henry781/binary-clock/hardware/bom.csv

References | Qty | Value | Description | Footprint | Manufacturer | MPN | Notes
U_MCU1 | 1 | ATmega328P-PU | 8-bit AVR microcontroller | Package_DIP:DIP-28_W7.62mm | Microchip | ATmega328P-PU | Narrow DIP-28; programmed over ISP
U3, U4, U5 | 3 | CD4040BE | 12-stage binary ripple counter, CMOS | Package_DIP:DIP-16_W7.62mm | Texas Instruments | CD4040BE
U11, U12, U13 | 3 | SN74HC245N | Octal bus transceiver, 3-state outputs | Package_DIP:DIP-20_W7.62mm | Texas Instruments | SN74HC245N | HC family (not HCT or LS)
U_LDO1 | 1 | MCP1700-3302E | 3.3 V LDO regulator, 250 mA | Package_TO_SOT_THT:TO-92_Inline_Wide | Microchip | MCP1700-3302E/TO | Pinout GND-VIN-VOUT; spread the leads to the 2.54 mm pitch
Q_DCF1 | 1 | 2N3904 | NPN transistor, level shifter | Package_TO_SOT_THT:TO-92_Inline_Wide | onsemi | 2N3904BU | Pinout E-B-C; spread the leads to the 2.54 mm pitch
Q_PT1 | 1 | TEPT5700 | Ambient light phototransistor, 5 mm | LED_THT:LED_D5.0mm | Vishay | TEPT5700 | Collector (short lead, flat side) on the square pad, like an LED
MOD_DCF1 | 1 | DCF-3850M-800 | DCF77 receiver module with ferrite antenna, 3.3 V | binary_clock:DCF77_Module_RC8000_Castellated_21.5x13mm |  | DCF-3850M-800 | Sold as "DCF77 receiver module DCF-3850M-800" (e.g. TinyTronics), 3.3 V version; antenna supplied; soldered flat by its castellated pads
Y1 | 1 | 32.768 kHz | Watch crystal, CL 12.5 pF, ±20 ppm | Crystal:Crystal_C38-LF_D3.0mm_L8.0mm_Horizontal | KDS | DT-38 | Load capacitance 12.5 pF (LCSC C93228)
D_R1-D_R5 | 5 | Red | LED 10 mm, red 625 nm, diffused, 60° | LED_THT:LED_D10.0mm | OptoSupply | OS5RPMA162A-LM | Any 10 mm diffused red LED, Vf ≈ 2.0 V
D_G1-D_G6 | 6 | Green | LED 10 mm, green 525 nm, diffused, 60° | LED_THT:LED_D10.0mm | OptoSupply | OSPG0262A-MN | Any 10 mm diffused green LED, Vf ≈ 3.2 V
D_B1-D_B6 | 6 | Blue | LED 10 mm, blue 470 nm, diffused, 60° | LED_THT:LED_D10.0mm | OptoSupply | OSB5SAA162A-KL | Any 10 mm diffused blue LED, Vf ≈ 3.2 V
D_TERM1 | 1 | 1N5817 | Schottky diode, 20 V 1 A | Diode_THT:D_DO-41_SOD81_P10.16mm_Horizontal | Vishay | 1N5817-E3/54 | Reverse-polarity protection
C_DEC_U3, C_DEC_U4, C_DEC_U5, C_DEC_U11, C_DEC_U12, C_DEC_U13, C_DEC_MCU_VCC1, C_DEC_MCU_AVCC1, C_AREF1, C_DCF_VCC1, C_PT1 | 11 | 100nF | Ceramic capacitor, X7R, 50 V, radial | Capacitor_THT:C_Disc_D5.0mm_W2.5mm_P5.00mm | KEMET | C322C104K5R5TA | Or any X7R radial MLCC with 5 mm lead spacing
C_LDO_IN1, C_LDO_OUT1 | 2 | 1uF | Ceramic capacitor, X7R, 50 V, radial | Capacitor_THT:C_Disc_D5.0mm_W2.5mm_P5.00mm | KEMET | C322C105K5R5TA | Must be ceramic (MCP1700 stability); this body is 7.4 mm wide, mount it slightly tilted or use a narrower 1 uF X7R part with 5 mm lead spacing
C1, C2 | 2 | 15pF | Ceramic capacitor, C0G/NP0, radial | Capacitor_THT:C_Disc_D5.0mm_W2.5mm_P5.00mm | SR Passives | CC-15/100 | C0G required (crystal load); 10 pF or 22 pF to trim the crystal frequency
C_BULK1 | 1 | 100uF | Aluminum electrolytic capacitor, 16 V, 105 °C | Capacitor_THT:CP_Radial_D6.3mm_P2.50mm | Panasonic | EEU-FC1C101 | Ø6.3 mm, 2.5 mm lead spacing
L_AVCC1 | 1 | 600R @ 100MHz | Ferrite bead, axial | Inductor_THT:L_Axial_L9.5mm_D4.0mm_P12.70mm_Horizontal_Fastron_SMCC | Würth Elektronik | 7427503 | Any axial bead of 600 Ω or more at 100 MHz; a body under Ø4.5 mm clears the MCU socket more easily
R_LED_R1-R_LED_R5 | 5 | 330 | Resistor, metal film, 0.25 W, 1 % | Resistor_THT:R_Axial_DIN0207_L6.3mm_D2.5mm_P10.16mm_Horizontal | Yageo | MFR-25FBF52-330R
R_LED_G1-R_LED_G6, R_LED_B1-R_LED_B6 | 12 | 220 | Resistor, metal film, 0.25 W, 1 % | Resistor_THT:R_Axial_DIN0207_L6.3mm_D2.5mm_P10.16mm_Horizontal | Yageo | MFR-25FBF52-220R
R_DCF_C1, R_DCF_OUT1, R_OE1, R_RST1 | 4 | 10k | Resistor, metal film, 0.25 W, 1 % | Resistor_THT:R_Axial_DIN0207_L6.3mm_D2.5mm_P10.16mm_Horizontal | Yageo | MFR-25FBF52-10K
R_PT1 | 1 | 470k | Resistor, metal film, 0.25 W, 1 % | Resistor_THT:R_Axial_DIN0207_L6.3mm_D2.5mm_P10.16mm_Horizontal | Yageo | MFR-25FBF52-470K | Sets the light-sensor range
R_DCF_VCC1 | 1 | 100 | Resistor, metal film, 0.25 W, 1 % | Resistor_THT:R_Axial_DIN0207_L6.3mm_D2.5mm_P10.16mm_Horizontal | Yageo | MFR-25FBF52-100R
SW1, SW2, SW3 | 3 | SW_Push | Tactile switch, 6 × 6 mm | Button_Switch_THT:SW_PUSH_6mm | C&K | PTS645SL50-2 LFS | Any 6 × 6 mm through-hole tactile switch
J_PWR2 | 1 | Screw terminal | Terminal block, 2 positions, 5.00 mm pitch | TerminalBlock_Phoenix:TerminalBlock_Phoenix_MKDS-1,5-2_1x02_P5.00mm_Horizontal | Phoenix Contact | 1715022 | MKDS 1,5/ 2 with 5.00 mm pitch; 5.08 mm variants do not fit
J_ISP1 | 1 | ISP Header | Pin header, 2 × 3, 2.54 mm | Connector_PinHeader_2.54mm:PinHeader_2x03_P2.54mm_Vertical | Würth Elektronik | 61300621121
J_DBG1 | 1 | UART Header | Pin header, 1 × 3, 2.54 mm | Connector_PinHeader_2.54mm:PinHeader_1x03_P2.54mm_Vertical | Würth Elektronik | 61300311121 | Optional (debug output)
Socket for U_MCU1 | 1 | DIP-28 | IC socket, machined pins, 7.62 mm row spacing |  | Preci-Dip | 110-93-328-41-001000 | Not in the schematic; narrow (7.62 mm) socket
Sockets for U3, U4, U5 | 3 | DIP-16 | IC socket, machined pins, 7.62 mm row spacing |  | Preci-Dip | 110-93-316-41-001000 | Not in the schematic
Sockets for U11, U12, U13 | 3 | DIP-20 | IC socket, machined pins, 7.62 mm row spacing |  | Preci-Dip | 110-93-320-41-001000 | Not in the schematic
