henry781/binary-clock/hardware/binary_clock.kicad_pcb

## KiCad design hardware/binary_clock.kicad_pcb (2026-10-31)

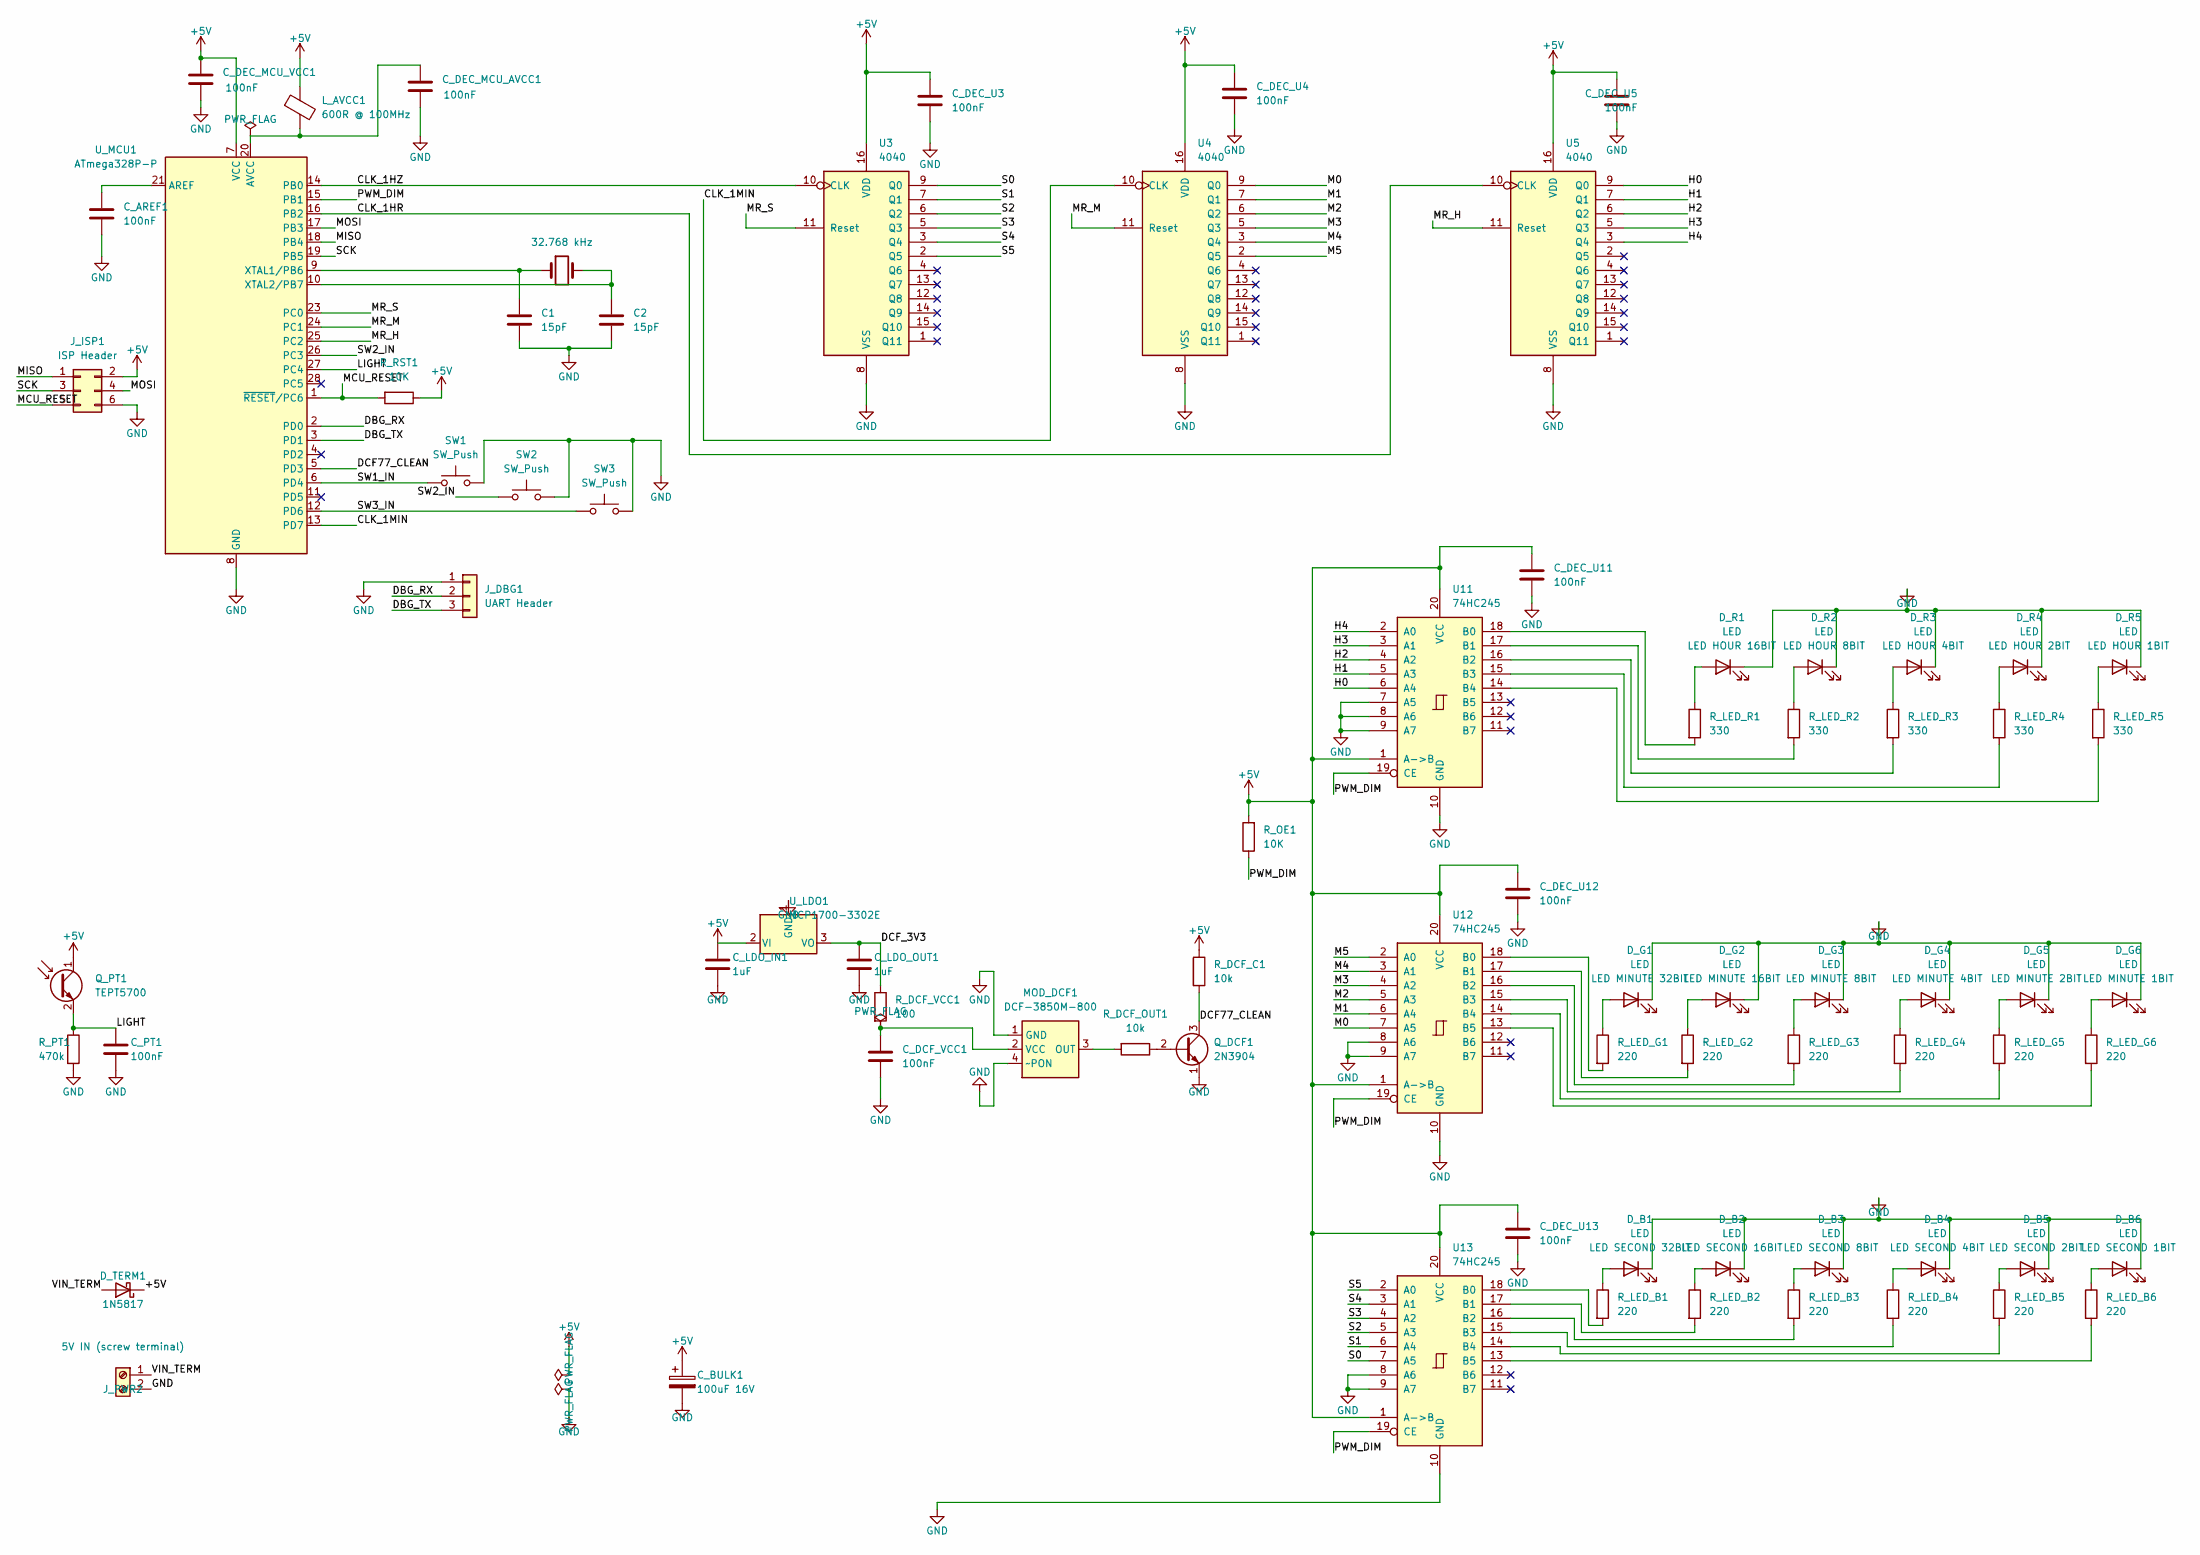
[picture p4: schematic binary_clock.kicad_sch, Binary Clock]

Parts:
C1, C2: 15pF; C_Disc_D5.0mm_W2.5mm_P5.00mm
C_AREF1: 100nF; C_Disc_D5.0mm_W2.5mm_P5.00mm
C_BULK1: 100uF 16V; CP_Radial_D6.3mm_P2.50mm
C_DCF_VCC1: 100nF; C_Disc_D5.0mm_W2.5mm_P5.00mm
C_DEC_MCU_AVCC1: 100nF; C_Disc_D5.0mm_W2.5mm_P5.00mm
C_DEC_MCU_VCC1: 100nF; C_Disc_D5.0mm_W2.5mm_P5.00mm
C_DEC_U3, C_DEC_U4, C_DEC_U5, C_DEC_U11, C_DEC_U12, C_DEC_U13: 100nF; C_Disc_D5.0mm_W2.5mm_P5.00mm
C_LDO_IN1: 1uF; C_Disc_D5.0mm_W2.5mm_P5.00mm
C_LDO_OUT1: 1uF; C_Disc_D5.0mm_W2.5mm_P5.00mm
C_PT1: 100nF; C_Disc_D5.0mm_W2.5mm_P5.00mm
D_B1, D_B2, D_B3, D_B4, D_B5, D_B6: LED; LED_D10.0mm
D_G1, D_G2, D_G3, D_G4, D_G5, D_G6: LED; LED_D10.0mm
D_R1, D_R2, D_R3, D_R4, D_R5: LED; LED_D10.0mm
D_TERM1: 1N5817; D_DO-41_SOD81_P10.16mm_Horizontal
J_DBG1: UART Header; PinHeader_1x03_P2.54mm_Vertical
J_ISP1: ISP Header; PinHeader_2x03_P2.54mm_Vertical
J_PWR2: 5V IN (screw terminal); TerminalBlock_Phoenix_MKDS-1,5-2_1x02_P5.00mm_Horizontal
L_AVCC1: 600R @ 100MHz; L_Axial_L9.5mm_D4.0mm_P12.70mm_Horizontal_Fastron_SMCC
MOD_DCF1: DCF-3850M-800; DCF77_Module_RC8000_Castellated_21.5x13mm
Q_DCF1: 2N3904; TO-92_Inline_Wide
Q_PT1: TEPT5700; LED_D5.0mm
R_DCF_C1: 10k; R_Axial_DIN0207_L6.3mm_D2.5mm_P10.16mm_Horizontal
R_DCF_OUT1: 10k; R_Axial_DIN0207_L6.3mm_D2.5mm_P10.16mm_Horizontal
R_DCF_VCC1: 100; R_Axial_DIN0207_L6.3mm_D2.5mm_P10.16mm_Horizontal
R_LED_B1, R_LED_B2, R_LED_B3, R_LED_B4, R_LED_B5, R_LED_B6: 220; R_Axial_DIN0207_L6.3mm_D2.5mm_P10.16mm_Horizontal
R_LED_G1, R_LED_G2, R_LED_G3, R_LED_G4, R_LED_G5, R_LED_G6: 220; R_Axial_DIN0207_L6.3mm_D2.5mm_P10.16mm_Horizontal
R_LED_R1, R_LED_R2, R_LED_R3, R_LED_R4, R_LED_R5: 330; R_Axial_DIN0207_L6.3mm_D2.5mm_P10.16mm_Horizontal
R_OE1: 10K; R_Axial_DIN0207_L6.3mm_D2.5mm_P10.16mm_Horizontal
R_PT1: 470k; R_Axial_DIN0207_L6.3mm_D2.5mm_P10.16mm_Horizontal
R_RST1: 10K; R_Axial_DIN0207_L6.3mm_D2.5mm_P10.16mm_Horizontal
SW1, SW2, SW3: SW_Push; SW_PUSH_6mm
U3, U4, U5: 4040; DIP-16_W7.62mm
U11, U12, U13: 74HC245; DIP-20_W7.62mm
U_LDO1: MCP1700-3302E; TO-92_Inline_Wide
U_MCU1: ATmega328P-P; DIP-28_W7.62mm
Y1: 32.768 kHz; Crystal_C38-LF_D3.0mm_L8.0mm_Horizontal

Connections:
+5V: C_BULK1.1, C_DEC_MCU_VCC1.1, C_DEC_U3.1, C_DEC_U4.1, C_DEC_U5.1, C_DEC_U11.1, C_DEC_U12.1, C_DEC_U13.1, C_LDO_IN1.1, D_TERM1.1 (K), J_ISP1.2, L_AVCC1.1, Q_PT1.1 (C), R_DCF_C1.1, R_OE1.2, R_RST1.1, U3.16 (VDD), U4.16 (VDD), U5.16 (VDD), U11.1 (A->B), U11.20 (VCC), U12.1 (A->B), U12.20 (VCC), U13.1 (A->B), U13.20 (VCC), U_LDO1.2 (VI), U_MCU1.7 (VCC)
/CLK_1HR: U5.10 (CLK), U_MCU1.16 (PB2)
/CLK_1HZ: U3.10 (CLK), U_MCU1.14 (PB0)
/CLK_1MIN: U4.10 (CLK), U_MCU1.13 (PD7)
/DBG_RX: J_DBG1.2, U_MCU1.2 (PD0)
/DBG_TX: J_DBG1.3, U_MCU1.3 (PD1)
/DCF77_CLEAN: Q_DCF1.3 (C), R_DCF_C1.2, U_MCU1.5 (PD3)
/DCF_3V3: C_LDO_OUT1.1, R_DCF_VCC1.1, U_LDO1.3 (VO)
/H0: U5.9 (Q0), U11.6 (A4)
/H1: U5.7 (Q1), U11.5 (A3)
/H2: U5.6 (Q2), U11.4 (A2)
/H3: U5.5 (Q3), U11.3 (A1)
/H4: U5.3 (Q4), U11.2 (A0)
/LIGHT: C_PT1.1, Q_PT1.2 (E), R_PT1.1, U_MCU1.27 (PC4)
/M0: U4.9 (Q0), U12.7 (A5)
/M1: U4.7 (Q1), U12.6 (A4)
/M2: U4.6 (Q2), U12.5 (A3)
/M3: U4.5 (Q3), U12.4 (A2)
/M4: U4.3 (Q4), U12.3 (A1)
/M5: U4.2 (Q5), U12.2 (A0)
/MCU_RESET: J_ISP1.5, R_RST1.2, U_MCU1.1 (~RESET/PC6)
/MISO: J_ISP1.1, U_MCU1.18 (PB4)
/MOSI: J_ISP1.4, U_MCU1.17 (PB3)
/MR_H: U5.11 (Reset), U_MCU1.25 (PC2)
/MR_M: U4.11 (Reset), U_MCU1.24 (PC1)
/MR_S: U3.11 (Reset), U_MCU1.23 (PC0)
/PWM_DIM: R_OE1.1, U11.19 (CE), U12.19 (CE), U13.19 (CE), U_MCU1.15 (PB1)
/S0: U3.9 (Q0), U13.7 (A5)
/S1: U3.7 (Q1), U13.6 (A4)
/S2: U3.6 (Q2), U13.5 (A3)
/S3: U3.5 (Q3), U13.4 (A2)
/S4: U3.3 (Q4), U13.3 (A1)
/S5: U3.2 (Q5), U13.2 (A0)
/SCK: J_ISP1.3, U_MCU1.19 (PB5)
/SW1_IN: SW1.1, U_MCU1.6 (PD4)
/SW2_IN: SW2.1, U_MCU1.26 (PC3)
/SW3_IN: SW3.1, U_MCU1.12 (PD6)
/VIN_TERM: D_TERM1.2 (A), J_PWR2.1
GND: C1.2, C2.2, C_AREF1.2, C_BULK1.2, C_DCF_VCC1.2, C_DEC_MCU_AVCC1.2, C_DEC_MCU_VCC1.2, C_DEC_U3.2, C_DEC_U4.2, C_DEC_U5.2, C_DEC_U11.2, C_DEC_U12.2, C_DEC_U13.2, C_LDO_IN1.2, C_LDO_OUT1.2, C_PT1.2, D_B1.1 (K), D_B2.1 (K), D_B3.1 (K), D_B4.1 (K), D_B5.1 (K), D_B6.1 (K), D_G1.1 (K), D_G2.1 (K), D_G3.1 (K), D_G4.1 (K), D_G5.1 (K), D_G6.1 (K), D_R1.1 (K), D_R2.1 (K), D_R3.1 (K), D_R4.1 (K), D_R5.1 (K), J_DBG1.1, J_ISP1.6, J_PWR2.2, MOD_DCF1.1 (GND), MOD_DCF1.4 (~PON), Q_DCF1.1 (E), R_PT1.2, SW1.2, SW2.2, SW3.2, U3.8 (VSS), U4.8 (VSS), U5.8 (VSS), U11.7 (A5), U11.8 (A6), U11.9 (A7), U11.10 (GND), U12.8 (A6), U12.9 (A7), U12.10 (GND), U13.8 (A6), U13.9 (A7), U13.10 (GND), U_LDO1.1 (GND), U_MCU1.8 (GND), U_MCU1.22 (GND)
unnamed: D_B1.2 (A), R_LED_B1.1
unnamed: D_B2.2 (A), R_LED_B2.1
unnamed: D_B3.2 (A), R_LED_B3.1
unnamed: D_B4.2 (A), R_LED_B4.1
unnamed: D_B5.2 (A), R_LED_B5.1
unnamed: D_B6.2 (A), R_LED_B6.1
unnamed: D_G1.2 (A), R_LED_G1.1
unnamed: D_G2.2 (A), R_LED_G2.1
unnamed: D_G3.2 (A), R_LED_G3.1
unnamed: D_G4.2 (A), R_LED_G4.1
unnamed: D_G5.2 (A), R_LED_G5.1
unnamed: D_G6.2 (A), R_LED_G6.1
unnamed: D_R1.2 (A), R_LED_R1.1
unnamed: D_R2.2 (A), R_LED_R2.1
unnamed: D_R3.2 (A), R_LED_R3.1
unnamed: D_R4.2 (A), R_LED_R4.1
unnamed: D_R5.2 (A), R_LED_R5.1
unnamed: MOD_DCF1.3 (OUT), R_DCF_OUT1.2
unnamed: C_DCF_VCC1.1, MOD_DCF1.2 (VCC), R_DCF_VCC1.2
unnamed: Q_DCF1.2 (B), R_DCF_OUT1.1
unnamed: R_LED_R1.2, U11.18 (B0)
unnamed: R_LED_R2.2, U11.17 (B1)
unnamed: R_LED_R3.2, U11.16 (B2)
unnamed: R_LED_R4.2, U11.15 (B3)
unnamed: R_LED_R5.2, U11.14 (B4)
unnamed: R_LED_G1.2, U12.18 (B0)
unnamed: R_LED_G2.2, U12.17 (B1)
unnamed: R_LED_G3.2, U12.16 (B2)
unnamed: R_LED_G4.2, U12.15 (B3)
unnamed: R_LED_G5.2, U12.14 (B4)
unnamed: R_LED_G6.2, U12.13 (B5)
unnamed: R_LED_B1.2, U13.18 (B0)
unnamed: R_LED_B2.2, U13.17 (B1)
unnamed: R_LED_B3.2, U13.16 (B2)
unnamed: R_LED_B4.2, U13.15 (B3)
unnamed: R_LED_B5.2, U13.14 (B4)
unnamed: R_LED_B6.2, U13.13 (B5)
unnamed: C_AREF1.1, U_MCU1.21 (AREF)
unnamed: C_DEC_MCU_AVCC1.1, L_AVCC1.2, U_MCU1.20 (AVCC)
unnamed: C1.1, U_MCU1.9 (XTAL1/PB6), Y1.1
unnamed: C2.1, U_MCU1.10 (XTAL2/PB7), Y1.2

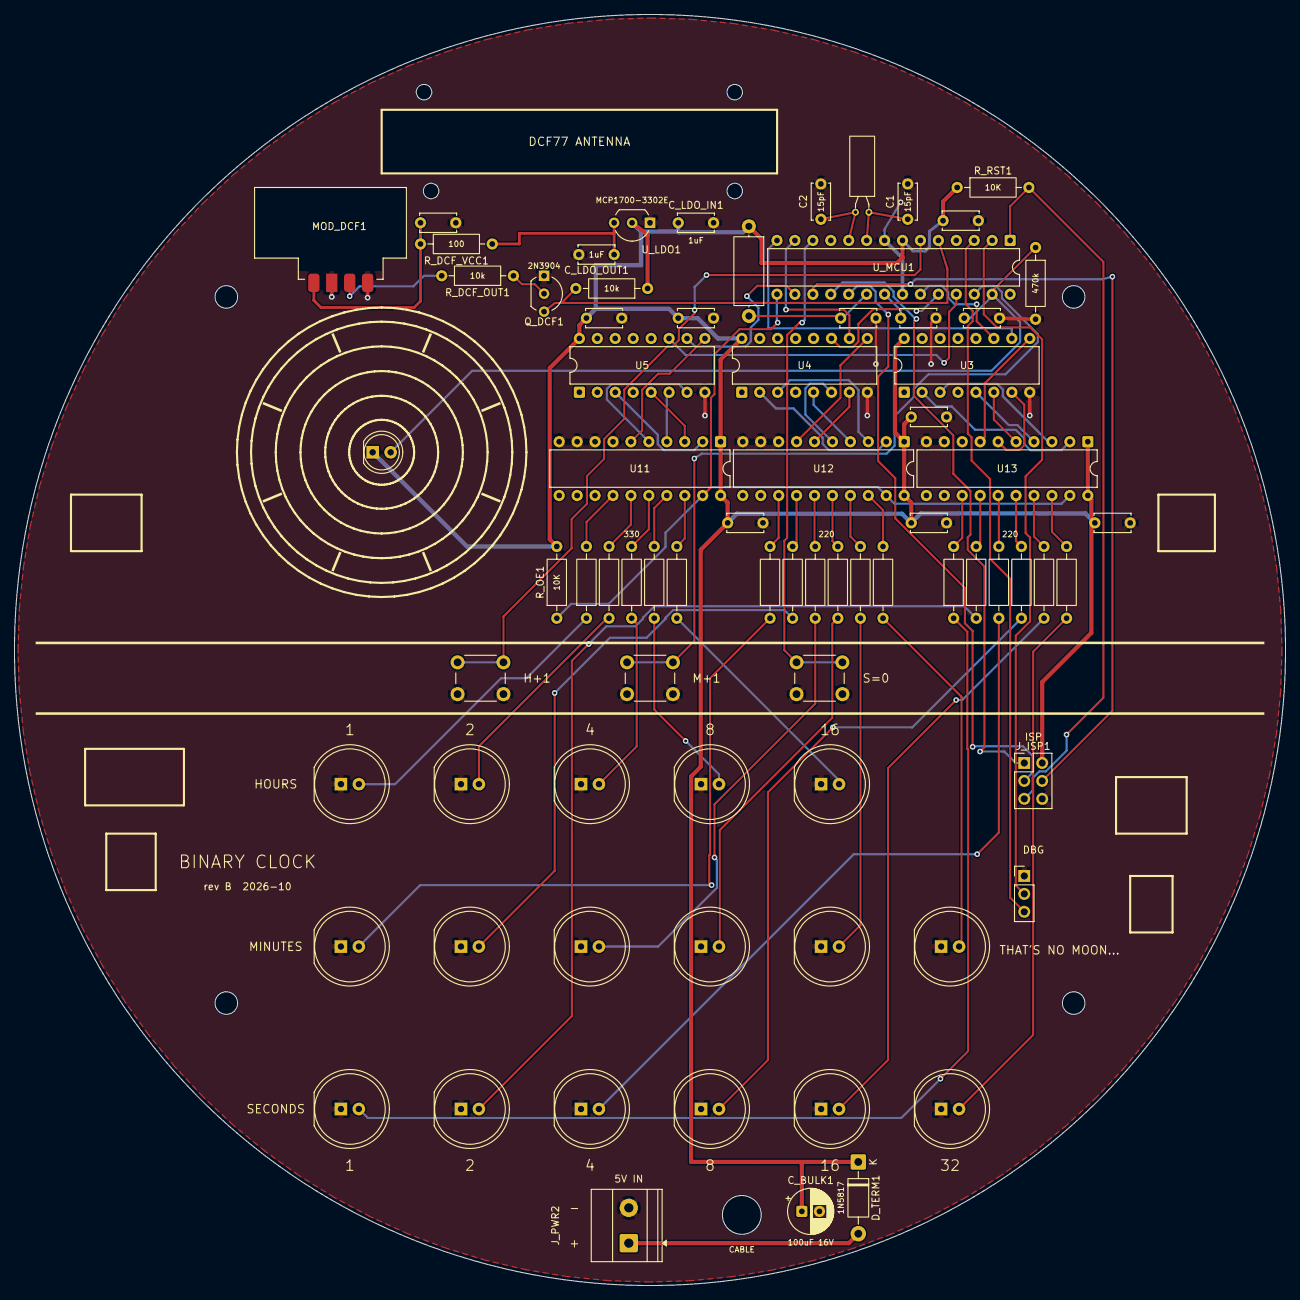
[picture p5: board binary_clock.kicad_pcb from above]

Board: 2 copper layers, 180.0 x 180.0 mm, 85 parts (0 on the bottom side), 80 nets.

Other parts of the board:
H_CABLE1: cable 5V; MountingHole_5.5mm
MH1, MH2, MH3, MH4: MountingHole_3.2mm; MountingHole_3.2mm_M3
MH5, MH6, MH7, MH8: MountingHole_2.2mm; MountingHole_2.2mm_M2
