henry781/binary-clock/(commit log)

2026-10-31 Binary clock: hardware, firmware and documentation
    Wall clock showing the time in binary on 17 LEDs, synchronized by DCF77
    and dimmed by the room light.
    - hardware/: KiCad 10 project (board revision B) and bill of materials
    - firmware/binary_clock/: ATmega328P firmware with a noise-tolerant
    DCF77 decoder
    - firmware/test/: PC simulator and regression tests of the decoder
    - firmware/tools/: bring-up sketches and crystal drift logger
    - docs/: hardware, firmware, decoder and build documentation
    [binary_clock.kicad_pcb, binary_clock.kicad_sch, bom.csv]
2026-10-31 doc: add pcb pictures
